loislo/esp32-swiss-weather/(list of files, cad)

Other CAD files:
case/swiss_weather_case.scad
