loislo/esp32-swiss-weather/(commit log)

2026-06-13 Initial commit: RuuviBeacon ESP32-S3 RuuviTag display
    Standalone Waveshare ESP32-S3-Touch-LCD-2.8 firmware: reads a RuuviTag over
    BLE and shows it on the 2.8" LCD with a temperature-colored reading, NTP
    clock, MeteoSwiss today/tomorrow forecast (auto-located via IP geolocation),
    PCM5101 chime on beacon (re)acquisition, CST328 touch backlight control, and
    low-battery / no-WiFi warnings.
    Config (WiFi, postal code) is set over a serial key=value console and stored
    in NVS — no credentials in source. Also includes a host-side Python scanner
    and a parametric OpenSCAD enclosure.
    [ruuvibeacon_case.scad]
2026-10-25 Rebuild the display around the Weather Screen design; add a printed case
    Screen
    - Implement the "Weather Screen 320x240" design: header, three-column hero
    (numeral, hairline-ruled spec column, condition figure), nine-hour forecast
    grid, and the beacon strip on a dark field.
    - The headline number is the RuuviTag's own measurement; MeteoSwiss supplies
    the range, condition and rain chance around it. HIGH/LOW/RAIN each read
    today -> tomorrow.
    - Switch to /v1/plzDetail. The forecast endpoint carries no
    precipitationProbability3h, which the rain figures and the bars need.
    - Condition labels come from the official MeteoSwiss symbol table (42 day
    codes, +100 for night), transcribed from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
    [ruuvibeacon_case.scad]
2026-10-25 Rename the project to ESP32 Swiss Weather
    Matches the repository name. "ESP32 Swiss Weather" in titles and prose,
    and a short [swiss-weather] tag in the serial log, which fits the short
    tags already used there ([geo], [meteo], [wifi], [ble], [cfg]).
    case/ruuvibeacon_case.scad -> case/swiss_weather_case.scad, and the STL
    names in the documented render commands follow it.
    RuuviTag is left alone: that is the sensor's own product name, not this
    project's. The ruuvi_* source filenames also stay, since they describe
    what reads the sensor, and renaming the display sketch would mean
    renaming its directory too and breaking the documented build commands.
    [swiss_weather_case.scad]
